Onkeliroh/Projekt-SS2013/README.txt

=====Installation=====
1. Install a Eclipse version
2. Install the Window Builder Plugin for Eclipse
3. Import the project into Eclipse
4. If nessesary add missing libraries to the project settings (RxTx-Lib is located in the corresponding 'lib' folder)
5. Run
