Onkeliroh/Projekt-SS2013/code/CC1101/readme.txt

SKETCHES
========

- Ordner für den Server v0.6 ist server_0_1
- Ordner für den sensorNode ist sensorNode_0_1
- Ordner für den ActuatorNode ist actuatorNode_0_1
- alle Ordner in das Standard-Verzeichnis für Sketches

LIBRARIES
=========

- ccPacketHandler.h und -.cpp
- ccNode.h und -.cpp
- ccServer.h und -.cpp
- ccActuatorNode.h und -.cpp
- ccSensorNode.h und -.cpp
- LPD6803.h und -.cpp
- analogComp.h und -.cpp
- LPD6803.h und -.cpp
- PinChangeInt.h
- SerialCommand.h und -.cpp
- Leds.h und -.cpp
- pearLeds.h und -.cpp
- alle Files in den Ordner "Arduino/libraries/panstamp"
- Ordner "accel" in den Ordner "Arduino/libraries"
