Onkeliroh/Projekt-SS2013/documentation/architecture.tex

\subsection{Architecture}
\subsubsection{Goals}

The main goal of the software is managing the incoming informations, from a via USB connected panstamp, and reacting, depending on the personality of the hardware, accordingly. To achieve this goal, we split this major goal into smaller ones and began working on one after another.
\newline
For the smaller goals we're implementing a basic serial port communication, creating a basic graphical user interface, getting to know thread and runnable concepts in Java and coming up with a general structure for managing the hardware devices.

\subsubsection{Preparation}
First we needed to implement a basic serial port communication for demonstration and understanding purposes. For that matter we wrote a small application using the RxTx-library to get a better understanding how the library behaves. This small application only wrote information to the serial outputstream and if there were available data incomming from the serial port, also read and printed them to the console.

After understanding the ground principles of the library we could begin planning the basic structure of the java server.

% vim: spell spelllang=en_gb
