Onkeliroh/Projekt-SS2013/documentation/documentation.tex

% Introduction
% If your a planing to contribute to this documentation, then please create 
% for every major "chapter" a new file with an meaningfull caption and add it 
% to this file using the "\input{<caption>}" function

\documentclass{acm_proc_article-sp}
\usepackage[utf8]{inputenc}
\usepackage[T1]{fontenc}
\usepackage[english]{babel}
\usepackage{amssymb} % set symbols i.e. /mathbb{N}
\usepackage[colorlinks=false, pdfborder={0 0 0}]{hyperref}
\usepackage{listings}
\usepackage{graphicx}

%Bibliogr.
\usepackage[numbers]{natbib}
\bibliographystyle{acm}

\begin{document}

%what is the corret title again?
\title{Documentation - Urban HCI\\Distributed Klick/Flickable Interfaces for Public Spaces}
%\subtitle{Subtitle}

%please check for the right number of authors
\numberofauthors{3}

%use to given format to add yourself as a author
\author{
  \alignauthor 
   Daniel Pollack \\
   \affaddr{Medieninformatik Bc.}\\
%   \affaddr{Matrikelnr.: 100488}\\
   \email{daniel.pollack@uni-weimar.de}   
   %
   \alignauthor 
  Jenny Gonzalez\\
   \affaddr{Computer Science and Media M.Sc. student}\\
%   \affaddr{Matriculation number: 112442}\\
   \email{jenny.carolina.gonzalez.\\acuna@uni-weimar.de}    
  \alignauthor 
   Ingo Schäfer \\
   \affaddr{Medieninformatik Bc.}\\
%   \affaddr{Matrikelnr.: 100488}\\
   \email{ingo.schaefer@uni-weimar.de}   
} 

\date{\today}

\maketitle

\input{abstract}
\input{related_work}
\input{concept}
\input{development}
\input{java-server}
\input{driver}
\input{hardware} 
\input{wheel}
\input{conclusions}

%TODO do we have sources?
\bibliography{sources}
%\listoftables
%\listoffigures

\end{document}
