Onkeliroh/Projekt-SS2013/documentation/graph/hall-sensor.png

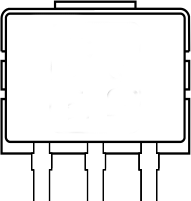
documentation/graph/hall-sensor.png
