Onkeliroh/Projekt-SS2013/documentation/graph/panstamp-pins.jpeg

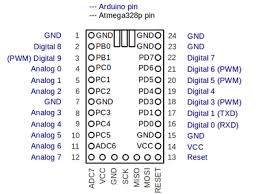
documentation/graph/panstamp-pins.jpeg
