Onkeliroh/Projekt-SS2013/documentation/graph/Panstamp-pins.png

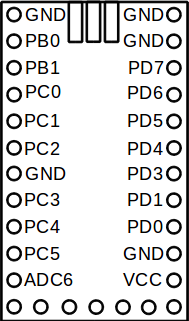
documentation/graph/Panstamp-pins.png
