Onkeliroh/Projekt-SS2013/documentation/pic/accelerometer.jpeg

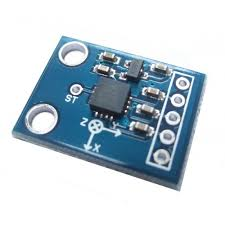
documentation/pic/accelerometer.jpeg
