Onkeliroh/Projekt-SS2013/documentation/pic/battery.jpeg

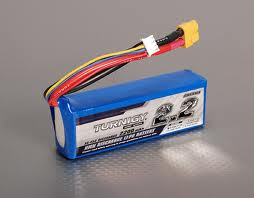
documentation/pic/battery.jpeg
