Onkeliroh/Projekt-SS2013/documentation/pic/dj_light.png

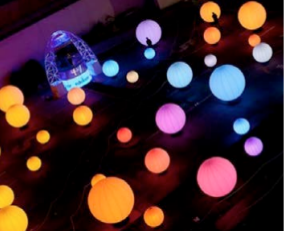
documentation/pic/dj_light.png
