Onkeliroh/Projekt-SS2013/documentation/pic/led-strand.jpeg

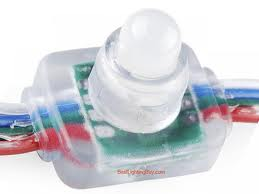
documentation/pic/led-strand.jpeg
