Onkeliroh/Projekt-SS2013/documentation/pic/led-strand.jpg

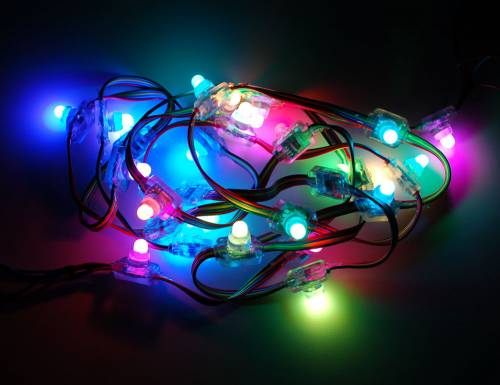
documentation/pic/led-strand.jpg
