Onkeliroh/Projekt-SS2013/documentation/graph/general.pdf

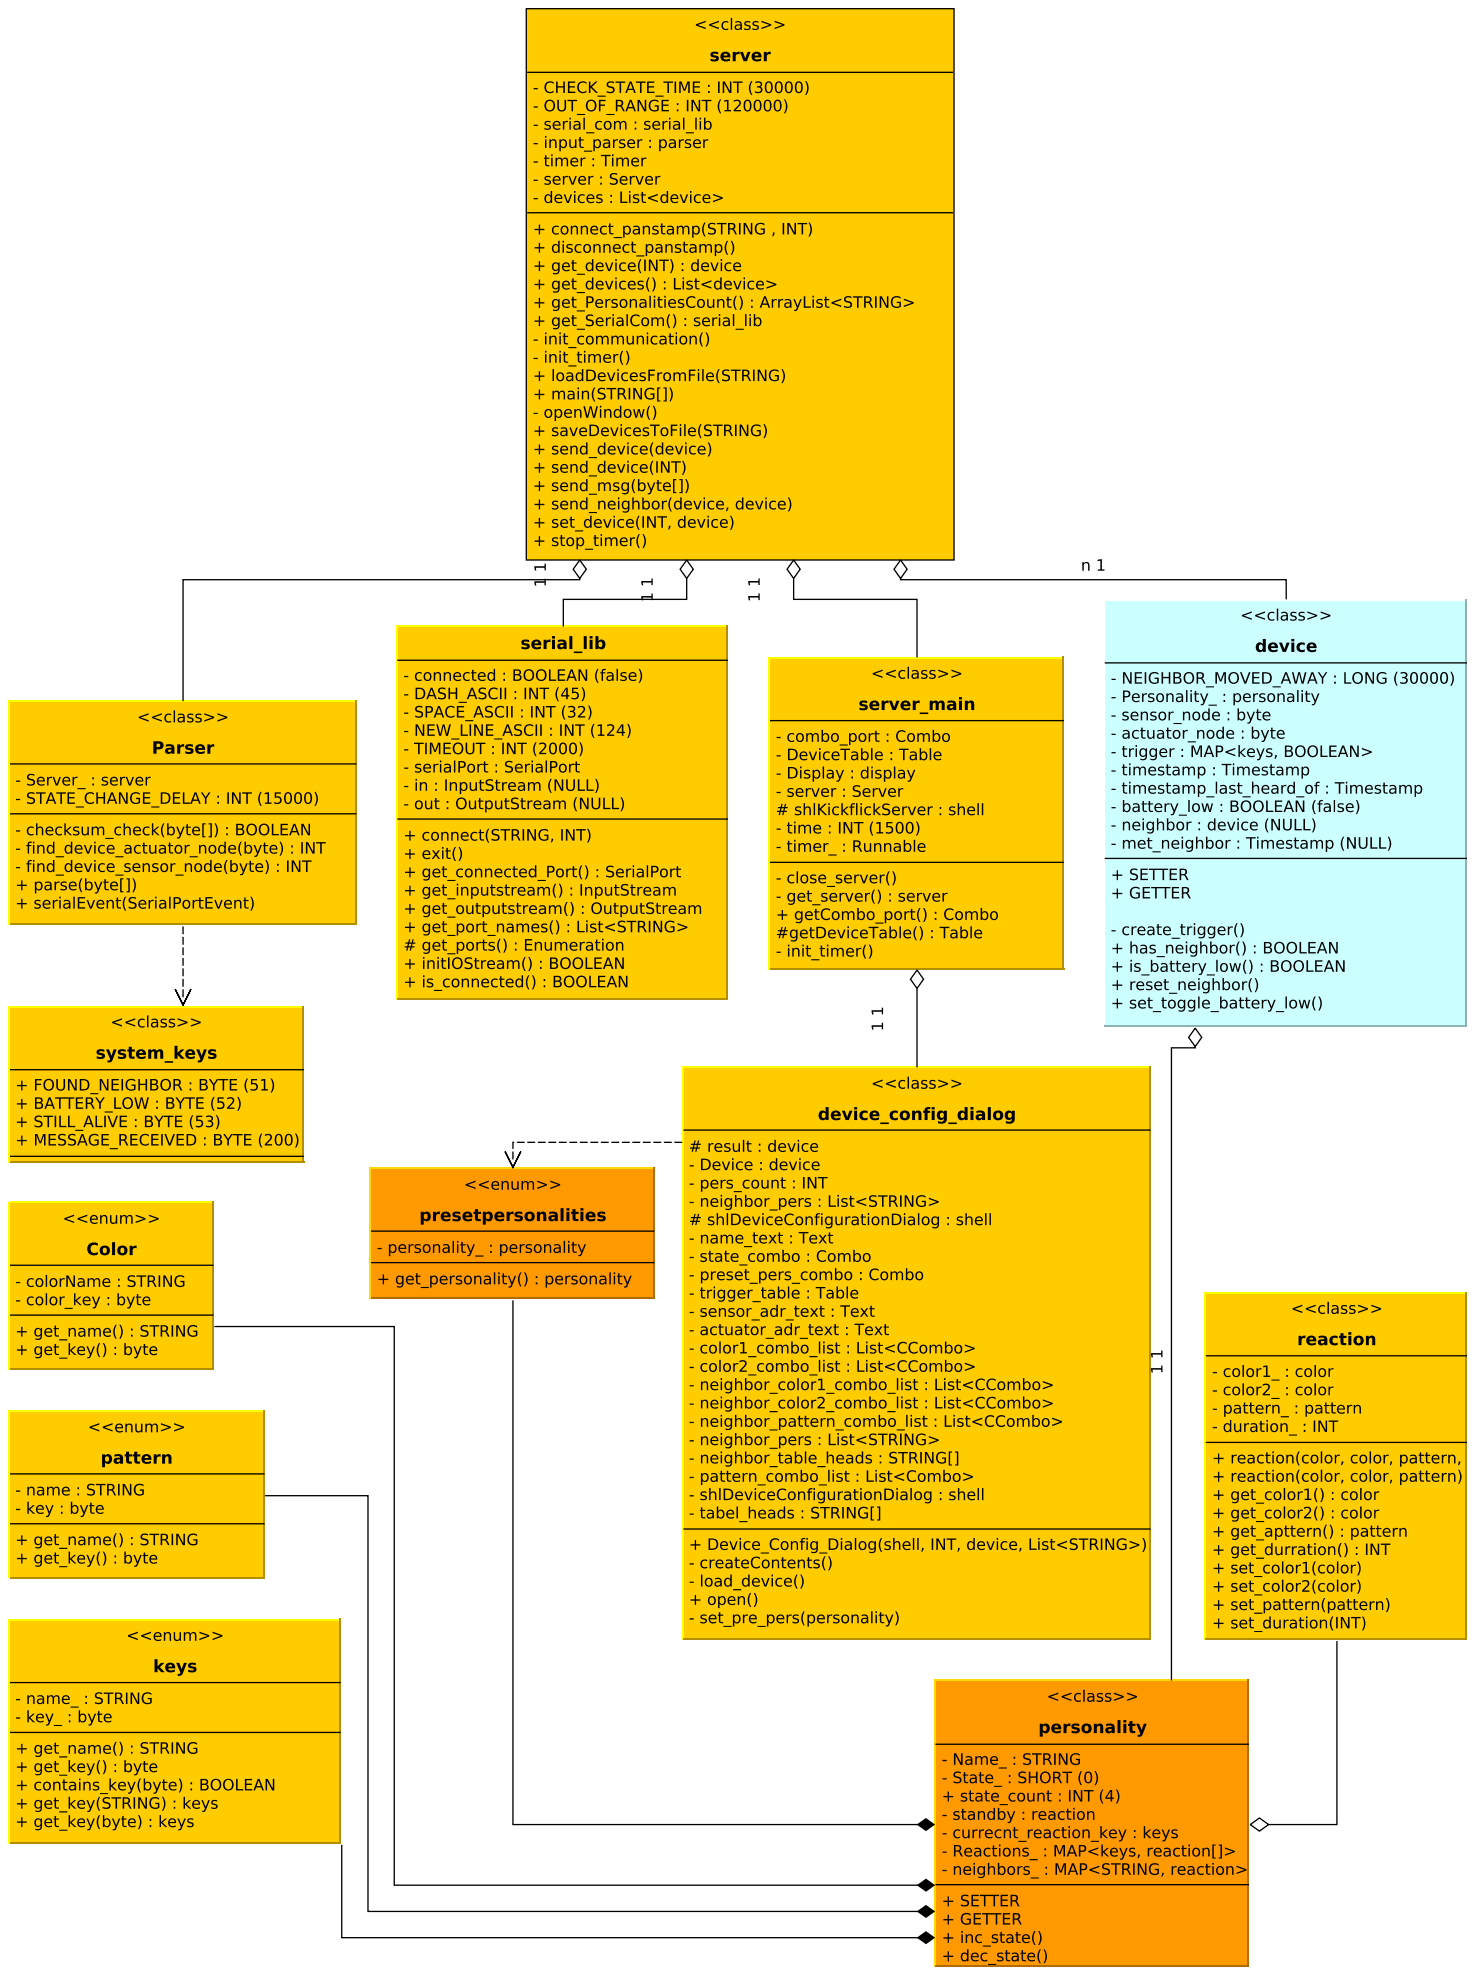
[picture p46: page 1]
