Onkeliroh/Projekt-SS2013/code/CC1101/ccPacketHandler.h

#ifndef CCPACKETHANDLER_H

#define CCPACKETHANDLER_H

#include "ccpacket.h"

#include "cc1101.h"


#define CCPACKETHANDLER_LENGTH           5  
#define CCPACKETHANDLER_MAXLENGTH       61

#define RECEIVER_ID     data[0] 
#define SENDER_ID       data[1]
#define ADMINKEY        data[2]

#define NEAR_NODE_ID    data[3]
#define NEAR_NODE_RSSI  data[4]


#define METAKEY         data[2]
#define COLOR1          data[3]
#define COLOR2          data[4]

#define RED             data[2]
#define BLUE            data[3]
#define GREEN           data[4]


///*ADMIN KEYS*///

/*EVENTS*/
#define TURN_LEFT_EVENT        27
#define TURN_RIGHT_EVENT       28

#define SHAKE_EVENT            31
#define KICK_EVENT             32

#define NEAR_NODE_EVENT        51
#define LOW_BATTERY            52
#define INRANGE                53

///*META KEYS*////
#define STRIPES                44
#define BACKWARD_CATERPILLAR   45
#define FORWARD_CATERPILLAR    46
#define CHANGE_COLOR           47

#define ACKNOWLEDGE           200



/*TEST CASES*/
#define TEST                  255

/*Ids*/
#define BROADCAST               0
#define SERVER_01               1
#define LED_CLIENT_01           2



class ccPacketHandler

{

    public:

        //--- TORS ---//

        ccPacketHandler();

        /// default d-tor

        ~ccPacketHandler();


        //--- STUFF ---//

        void initialize();

        void clearPacket();

        void buildPacket(byte receiver, byte sender, byte adminKey);

        void addToPacket(byte data);

        void buildDetectedNodePacket(byte sender, byte neighbourID);

        void buildRSSIPacket(byte sender, byte rawRSSI, byte neighbourID);
 
        void buildPatternCommand(byte receiver, byte PatternKey, byte colorKey1, byte colorKey2);

        /// setters

        void setHash(byte ccHash);

        void setBuildCounter(int counter);

        /// getters

        byte getHash();

        int getBuildCounter();



        //--- SENDING ---//

        void sendPacket();

        /// setters

        void setPacket(CCPACKET ccPacket);

        void setReceiver(byte receiver);

        void setSender(byte sender);

        void setAdminKey(byte adminKey);

        void setMetaKey(byte metaKey);

        void setFirstColor(byte firstColor);

        void setSecondColor(byte secondColor);

	void setRed(byte colorRed);

	void setBlue(byte colorBlue);

	void setGreen(byte colorGreen);

        void setDetectedRSSI(byte rawRSSI);        

        void setNeighbourId(byte neighbourID);


        /// getters

        CCPACKET getPacket();

        byte getPacketReceiver();

        byte getPacketSender();

        byte getAdminKey();

        byte getMetaKey();

        byte getFirstColor();

        byte getSecondColor();

	byte getRed();

	byte getBlue();

	byte getGreen();

        byte getPackNum();
      
        byte getPacketRSSI();
        
        void printPacket(); 
       
        boolean hashMatches();

        byte ccHash();

        boolean _ccClear;

    private:
        CCPACKET _ccPacket; 
        
        byte _hash;

        int _buildCounter;
        
};



#endif // CCPACKETHANDLER_H
