Onkeliroh/Projekt-SS2013/code/CC1101/ccServer.h

#ifndef CCSERVER_H

#define CCSERVER_H

#include "ccPacketHandler.h"
#include "ccNode.h"

#define BUFFERLENGTH 4

//From Java Server to Panstamp
#define RECEIVERID  buffer[0]
#define METAKEY     buffer[1]
#define COLOR1      buffer[2]
#define COLOR2      buffer[3] 

//From Panstamp to Java Server
#define SENDERID    0
#define KEY         1
#define DUMMY       2
#define NEARNODEID  2
#define CHECKSUM    3 

#define BUFFERHASH 4 

#define NULL 0


class CCSERVER: public CCNODE
{

	public:
                CCSERVER(byte id);
                ~CCSERVER();

                void setup();
                 
                boolean ccGetNewPacket(void);
                void ccHandle(void); 
               
                void cleanBuffer();              
                byte getBufferChecksum();
                void setBuffer();
                void setNearNodeBuffer();
                void sendBufferToJavaServer();              

                boolean newJavaCommand();
                void getJavaCommand();
                void setNewCommand();
                void ccSendCommand(); 
   
        private:           
                byte buffer[BUFFERLENGTH];                  
};

#endif // CCSERVER_H
