Onkeliroh/Projekt-SS2013/(commit log)

2013-05-23 arduino sketches added and serial_communicator improved
2013-06-25 Edit
    - Flussdiagramm korrigiert
    - Keys als Tabelle hinzugefügt
    [Guppy-Keys.ods]
2013-07-01 sensor keys added
    [sensor_keys.ods]
2013-07-01 key changes, uml extended
    [sensor_keys.ods]
2013-07-03 Edit
    Test-Keys aktualisiert
    [Guppy-Keys.ods]
2013-07-04 ein haufen zeug
    - acknowledge hinzu
    - LED-client hinzu
    - Readme aktualisiert
    [Guppy-Keys.ods]
2013-07-05 update
    - keys aktualisiert
    - bidirektionalen server angelegt (v0.5)
    [Guppy-Keys.ods]
2013-07-05 the eagle has landed
    - wheel-client added
    - keys updated
    - server update
    - packet handler updated
    - libraries extended
    - readme extended
2013-07-06 moved code to folder 'code'
    [sensor_keys.ods]
2013-07-08 added summary text, -completed key numeration for now
    [Guppy-Keys.ods]
2013-07-11 added classes for sensors+actuators, actualized guppy-list
    [Guppy-Keys.ods]
2013-07-11 new: enum color
    [Guppy-Keys.ods]
2013-08-07 modified: code/CC1101/Accel_client_0_1/Accel_client_0_1.ino new file: code/CC1101/Accel_client_0_1/PinChangeInt.h modified: code/CC1101/LED_client_0_3/LED_client_0_3.ino new file: code/CC1101/analogC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
2013-08-08 added empty timer method
2013-08-08 modified: code/CC1101/Readme.txt new file: code/CC1101/server_0_6/server_0_6/server_0_6.ino deleted: code/CC1101/LED_client_0_1/LED_client_0_1.ino deleted: code/CC1101/LED_client_0_1/LPD6803.h delete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
2013-08-08 deleted: code/CC1101/LED_client_0_1/LED_client_0_1.ino deleted: code/CC1101/LED_client_0_1/LPD6803.h deleted: code/CC1101/LED_client_0_2/LED_client_0_2.ino deleted: code/CC1101/LED_client_0_2/LPD6803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
2013-08-09 peronalities now know their device, and some changes to the constructors
2013-08-16 added device list getter, added some error messages
2013-08-28 - changed pattern and color representation -> now just 1 byte identifier - device now controlles it's personality
2013-08-30 device table, refresh - function, config - button, newDevice - button ... partly unchecked
2013-09-03 config dialog now loads partialy device informations, device now know on with trigger event to react
2013-09-03 added new key moddel
    [remodeled_keys.ods]
2013-09-05 added output functionality to parser, some bug fixes, new enumerations for all key values, new bug in overwritting device
    [remodeled_keys.ods]
2013-09-06 extended configurations dialog
    [remodeled_keys.ods]
2013-09-08 fixed device config bug
2013-09-09 bug fixing, config interface is ok for one device, key recognition works
2013-09-10 added timer to reset device state, added time threashold to device reaction
2013-09-15 Changes to the communication between server and actuatornode
2013-09-16 New classes that manage leds
2013-09-17 Resolved communication issues. Added new sensorNode Sketch :-)
    [Leds.h, TimerOne.h, actuatorNode_0_1.ino, ccActuatorNode.cpp, ccActuatorNode.h, ccNode.h, ccPacketHandler.cpp, ccSensorNode.cpp]
2013-09-18 added battery state, last heard of timestamp, extended parser
2013-09-18 added battery display
2013-09-30 fixed device update timeout
2013-09-30 serial communication fixed
    [Guppy-Keys.ods, sensor_keys.ods]
2013-09-30 Deleting wrong folders in repository
    [Guppy-Keys.ods, sensor_keys.ods]
2013-10-01 fixed bug were deviced who were declared 'out of range' were set to default state again and again
2013-10-03 added neighbor options to device class
2013-10-04 -added patterns, updated parser and neighborhood detection, made messageboxes asyncronus threads
2013-10-06 added flowgraph try, deleted old files
2013-10-21 changes in the thresholds and sensorNode code
2013-10-21 fixed device loading
2013-10-24 cleaned repo
    [Guppy-Keys.ods, remodeled_keys.ods, sensor_keys.ods]
2015-02-19 "updated gitignore, Device_Config_Dialog imports cleand up, generated documentation pdf"
